088a2/60-Keyboard/README.md

# DIY 60% Keyboard





  



---

A custom 60% ortholinear mechanical keyboard, built from scratch with a 3D-printed case and handwired matrix.  
Powered by an **ESP32-S3 Zero** microcontroller and programmed in **C++** for key scanning, debouncing, and USB HID input.

---

## Table of Contents

- [DIY 60% Keyboard](#diy-60-keyboard)
  - [Table of Contents](#table-of-contents)
  - [Features](#features)
  - [Components](#components)
  - [Tools \& Software](#tools--software)
  - [Wiring (high level)](#wiring-high-level)
  - [Assembly](#assembly)
  - [Keyboard Layout](#keyboard-layout)
    - [Layers](#layers)
  - [Design \& Gallery](#design--gallery)
  - [3D Print Settings](#3d-print-settings)
    - [Case \& plate](#case--plate)
    - [Keycaps](#keycaps)
  - [Pin Mapping](#pin-mapping)
  - [Firmware](#firmware)
    - [Quick start (Arduino IDE)](#quick-start-arduino-ide)
    - [Firmware notes](#firmware-notes)
  - [Future Improvements](#future-improvements)
  - [License](#license)

---

## Features

- Ortholinear (grid-style) key layout  
- 3D-printed case and plate design  
- Handwired switch matrix with diodes  
- ESP32-S3 Zero for USB HID functionality  
- Firmware written in C++ (Arduino / PlatformIO compatible)

---

## Components

- ESP32-S3 Zero (microcontroller)  
- 63 × Blue mechanical switches
- 63 × 1N4148 diodes (one per switch)  
- Keycaps Cherry MX style
- Wires (24-26 AWG preferred for handwiring)  
- 3D-printed case & plate  
- Screws, brass threaded inserts, stabilizers

---

## Tools & Software

- **Design & CAD**: Fusion 360
- **Slicing & Printing**: Orca Slicer & FDM 3D Printer
- **Firmware Development**: Arduino IDE / PlatformIO  
- **Programming Language**: C++  
- **Microcontroller Platform**: ESP32-S3 Zero  

---

## Wiring (high level)

1. Decide your matrix rows × columns based on your ortholinear layout (common 60% ortholinear uses a grid sized to the key count).  
2. Handwire switches into a matrix: one side of each switch goes to a row wire, the other side goes through a diode to a column wire.  
3. **Diode orientation:** place the **1N4148** diode on each switch such that current flows from the switch toward the column/scan line. In practice, orient the diode with its **striped end (cathode)** pointing to the column/scan line (the MCU side). This prevents ghosting during matrix scanning.  
4. Route row and column wires to ESP32-S3 Zero GPIOs. Reserve a few extra GPIOs for indicators or encoders if needed. Use internal pull-ups or external resistors per your scanning routine.

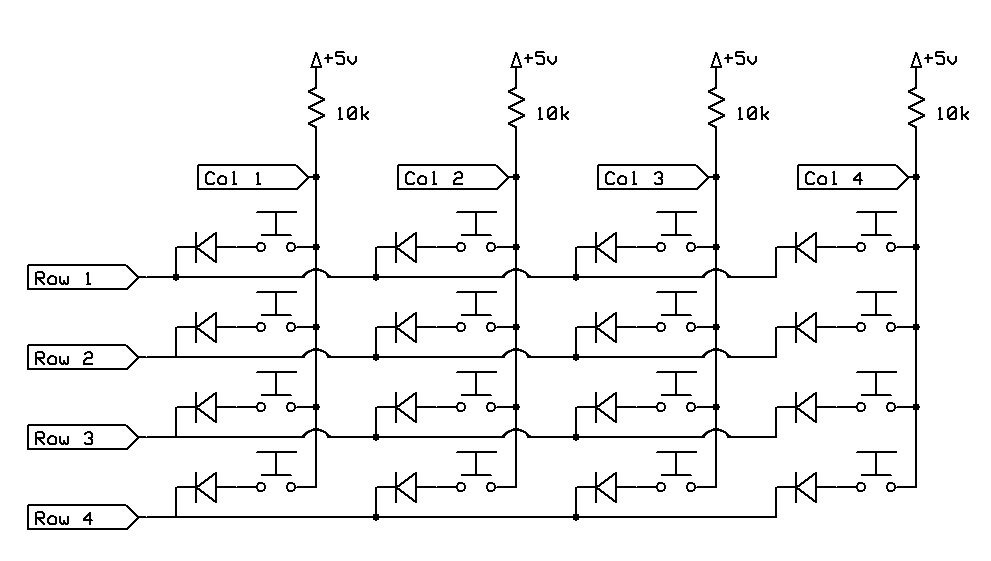
[picture p1: images/Keyboard_Matrix_Circuit.png]
Final Keyboard
  
*Keyboard Matrix Circuit — [Arduino Forum Reference](https://forum.arduino.cc/t/what-is-the-actual-circuitry-of-a-keypad-and-the-switch/1046828)*

---

## Assembly

- 3D-print the case and plate. Test fit switches and stabilizers before final assembly.  
- Solder diodes to switch pins first (striped end toward column).
- Solder row/column buses and label them (R0, R1, ... / C0, C1, ...).  
- Connect buses to the ESP32-S3 Zero following your planned pin mapping. Secure the MCU and wiring inside the case, then close and mount.

---

## Keyboard Layout

The keyboard follows a 60% ortholinear grid layout with layered functionality.  
This provides a compact footprint while still maintaining all essential keys.  

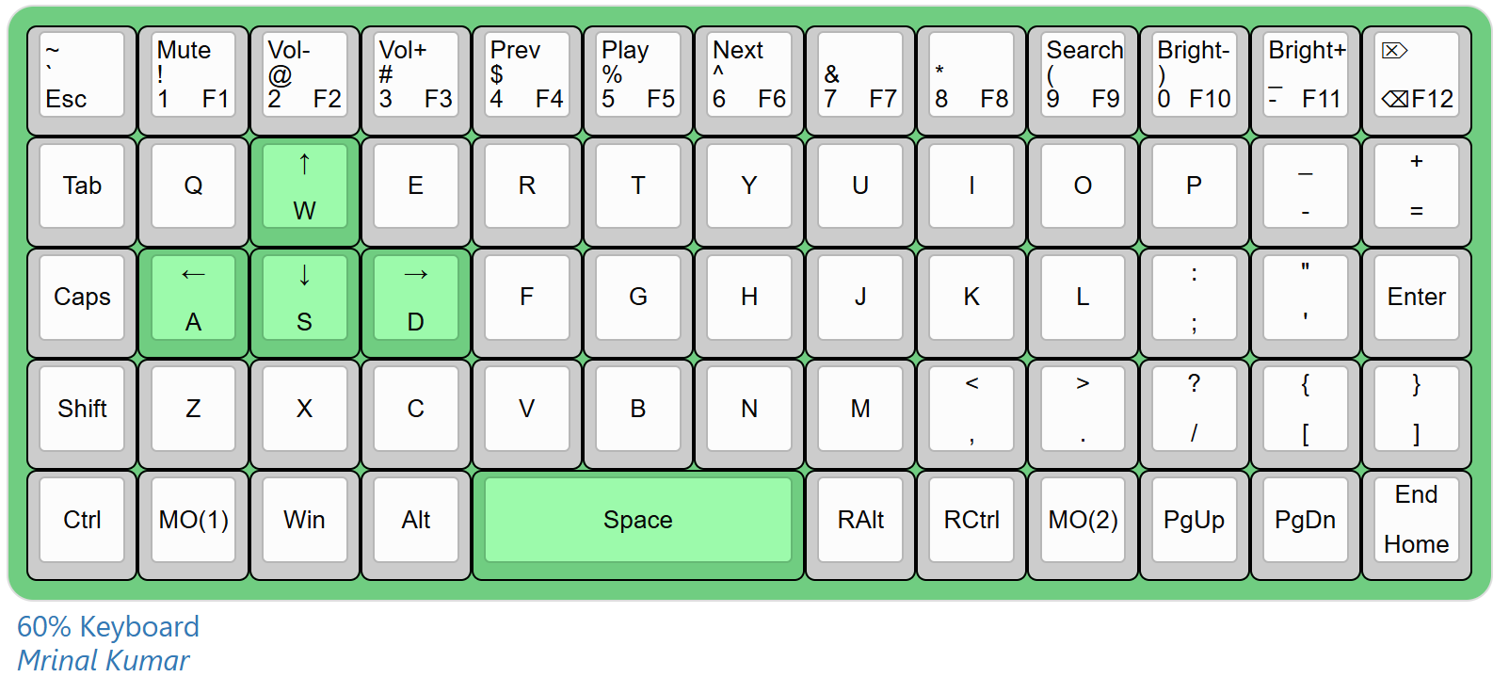
[picture p2: images/Keyboard_Layout.png]
Keyboard_Layout
  
*Keyboard layout (visualized using [Keyboard Layout Editor](https://www.keyboard-layout-editor.com/#/)).*

### Layers

- **Layer 1 (Default):** Standard typing layer with alphanumeric keys, modifiers, and space.  
- **Layer 2 (MO):** Media controls (volume, play/pause, next/previous).  
- **Layer 3 (MO):** Function keys (F1–F12) and system shortcuts.  

The editable layout file is included here: [`Keymap\60_keyboard.json`](./Keymap\60_keyboard.json)

---

## Design & Gallery

The complete CAD model of the keyboard is included in the repository:  

- [`3d_model/60_keyboard.step`](./3D_Model/60_Keyboard.step)

---

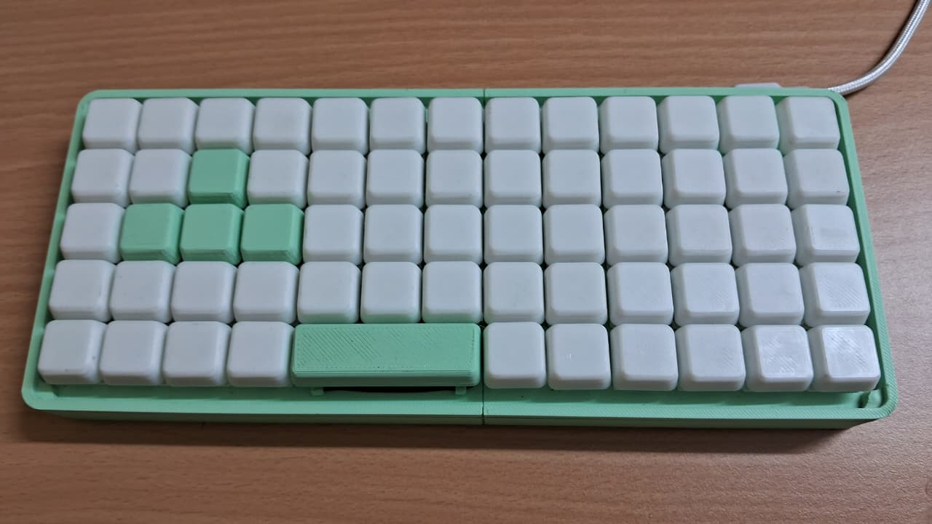
[picture p3: images/60_Keyboard.jpeg]
60_Keyboard 1

*60% keyboard*

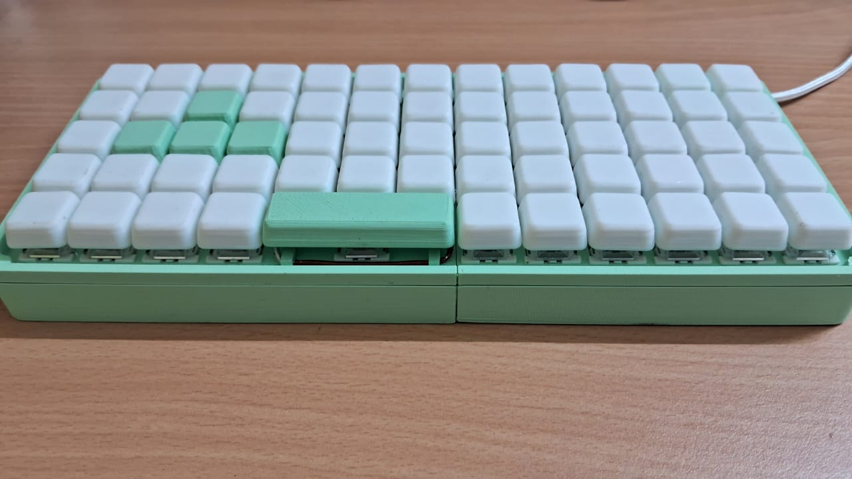
[picture p4: images/60_Keyboard_2.jpeg]
60_Keyboard 2
  
*60% keyboard*

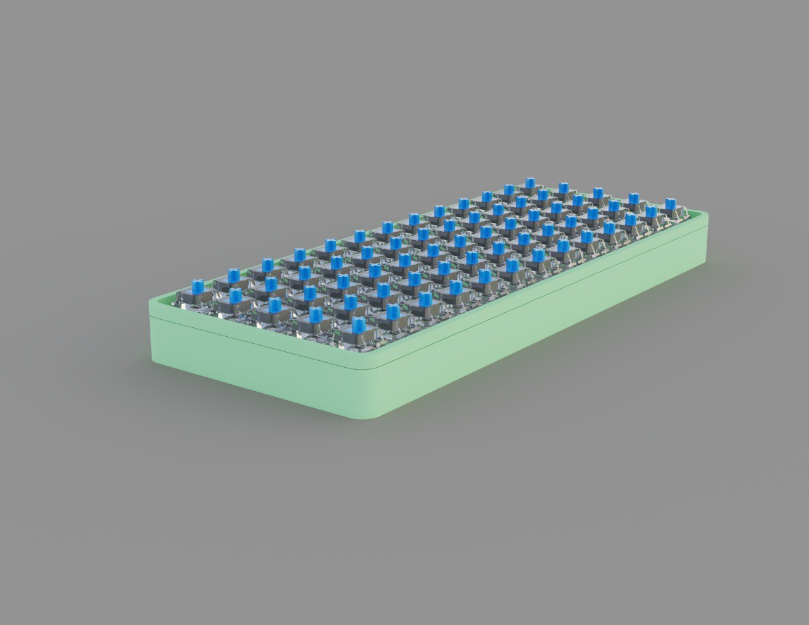
[picture p5: images/3D_Render_Old.jpeg]
3D Render Old
  
*Early render — initial concept.*

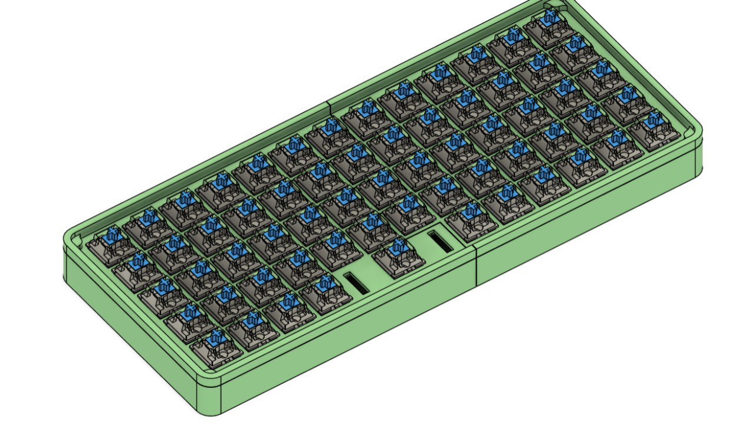
[picture p6: images/3D_Model_2.png]
3D Model 2
  
*3D model — top view.*

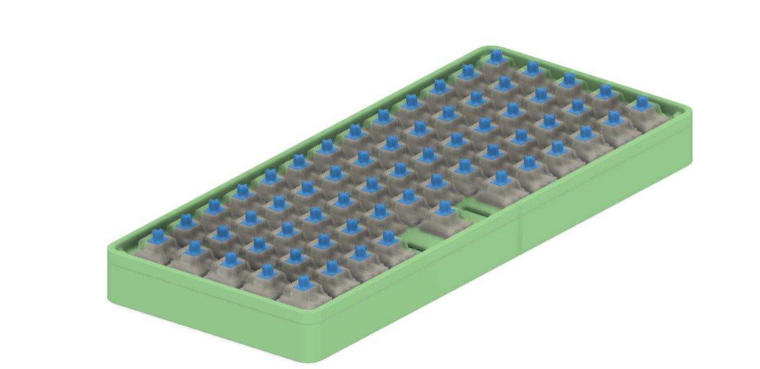
[picture p7: images/3D_Model_1.png]
3D Model 1
  
*3D model — case design.*

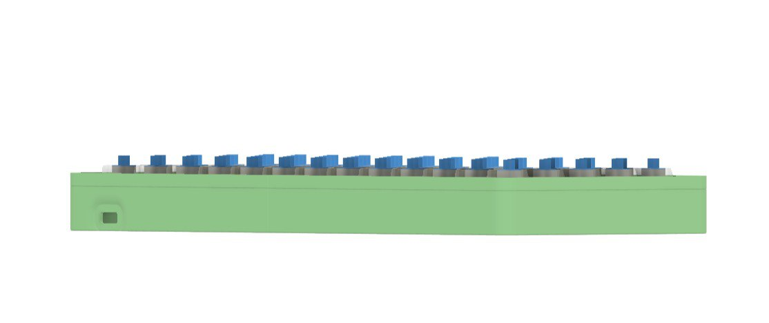
[picture p8: images/3D_Model_3.jpeg]
3D Model 3
  
*3D model — side view.*

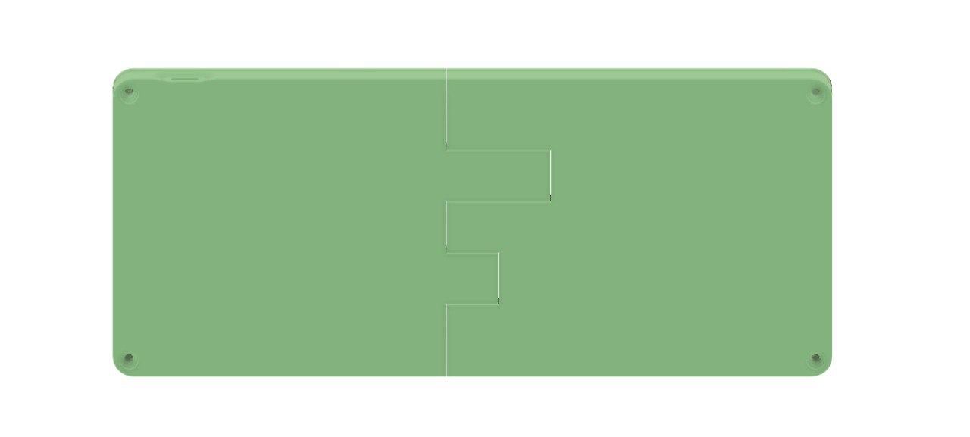
[picture p9: images/3D_Model_4.jpeg]
3D Model 4
  
*3D model — bottom view.*

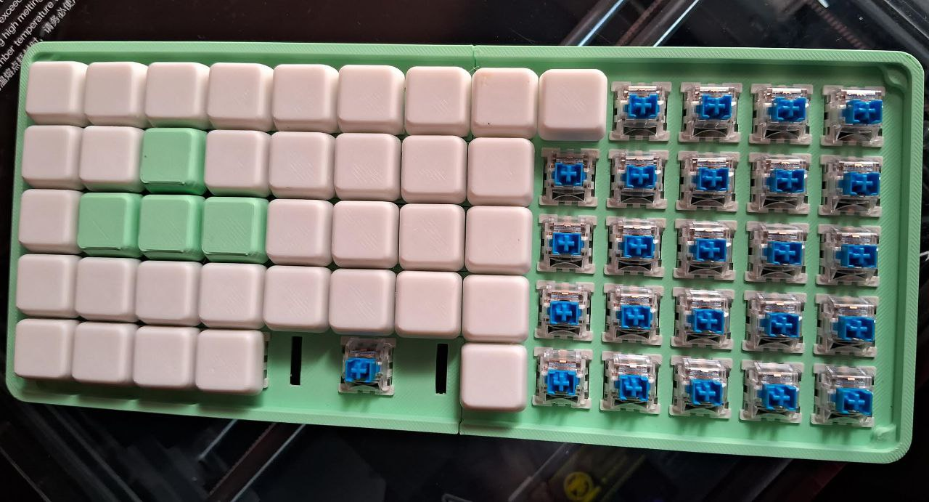
[picture p10: images/Added_Keys.png]
Added Keys
  
*Partial assembly*

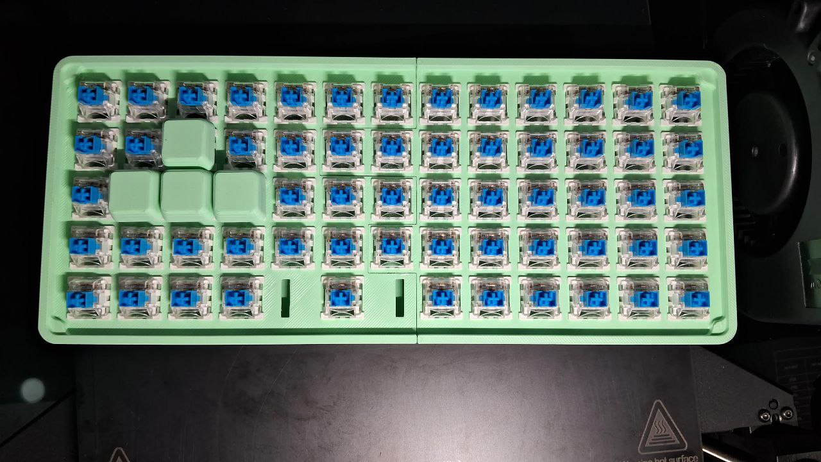
[picture p11: images/No_keycaps.png]
No keycaps
  
*Top view without keycaps — switch layout.*

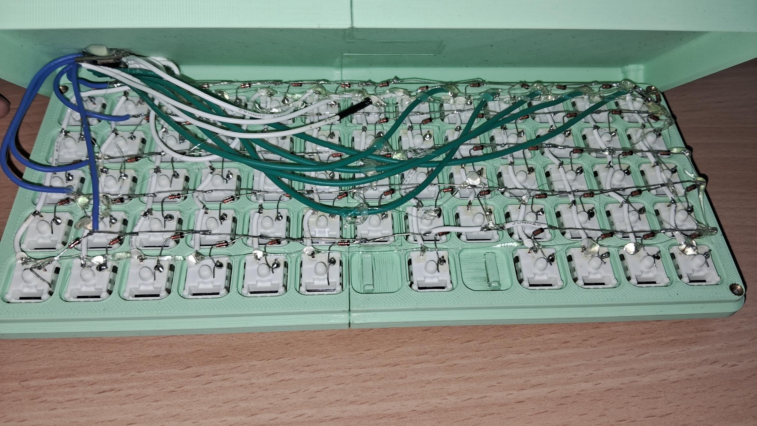
[picture p12: images/Circuit.jpg]
Handwired circuit
  
*Handwired matrix circuit*

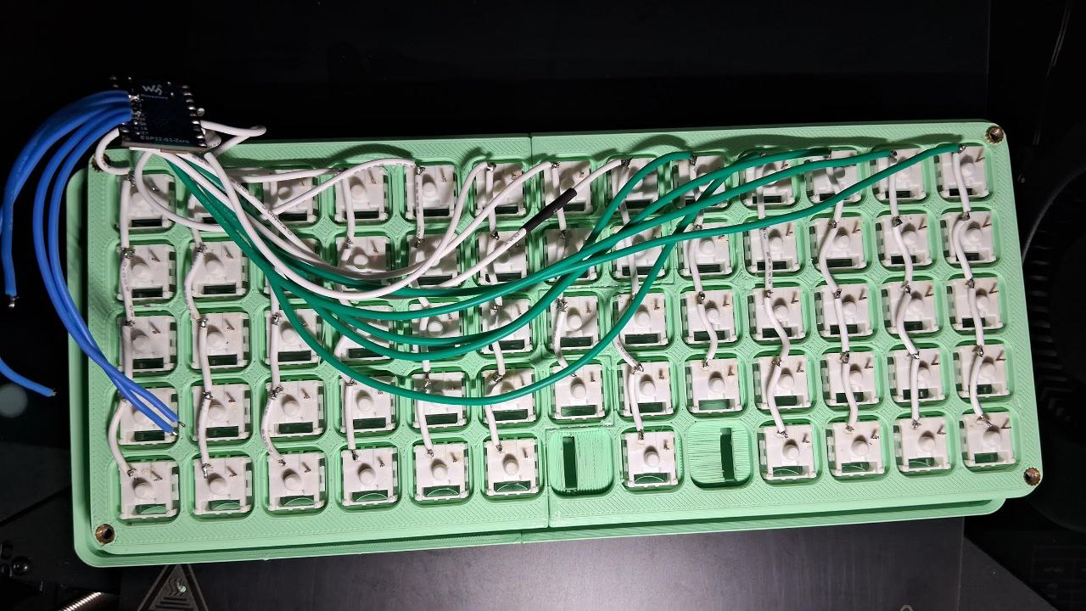
[picture p13: images/Handwired_circuit.png]
Handwired circuit
  
*Handwired matrix — bus routing. (Without Diodes)*

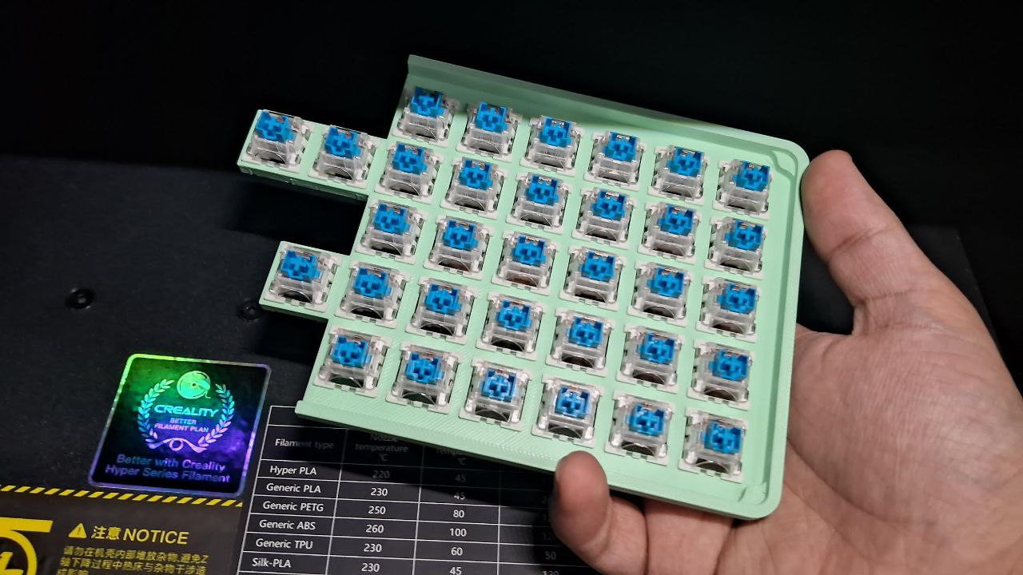
[picture p14: images/Top_Right_Frame_with_keys.png]
Top Right Frame with keys
  
*Top-right — keycap test fit.*

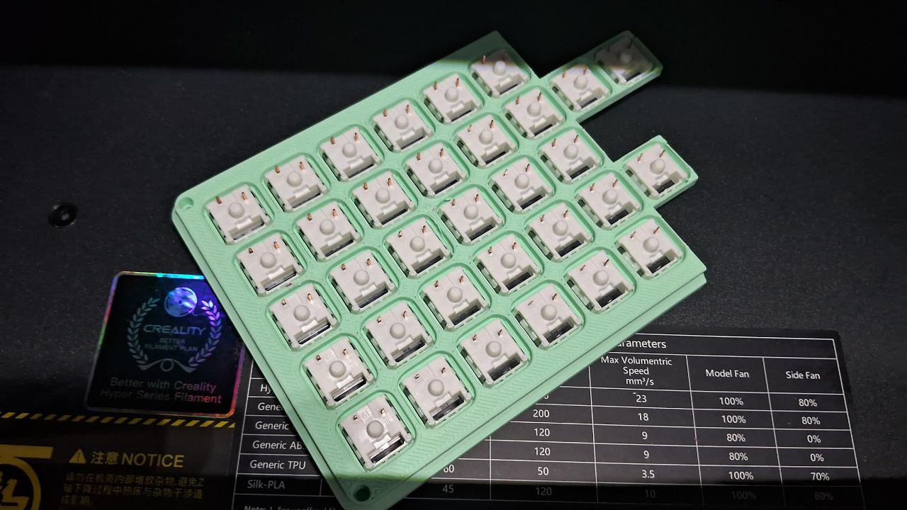
[picture p15: images/Frame_Backside.png]
Frame Backside
  
*Top-right — underside and keycaps points.*

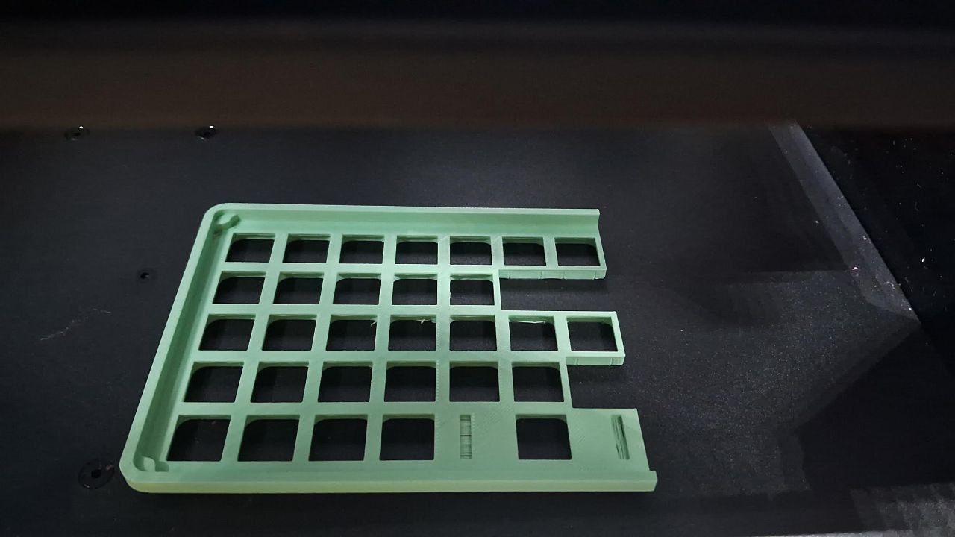
[picture p16: images/Top_left_frame.png]
Top left frame
  
*Top-left — Plate.*

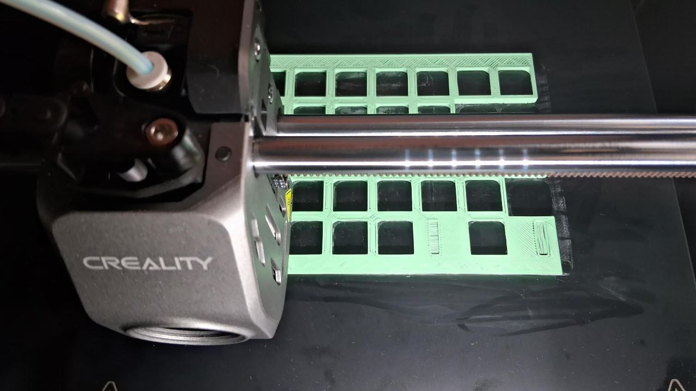
[picture p17: images/3D_Print.png]
3D_Print
  
*Top-Left — 3D Print.*

---

## 3D Print Settings

**Model:** The whole model is support free

**Printer:** any FDM printer with a 0.4 mm nozzle.

**Material:** PLA (recommended) - PETG or ABS for higher heat resistance

### Case & plate

- Layer height: **0.20 mm**
- Infill: **15%**
- Adhesion: none
- Supports: **none** (model designed support-free)  

### Keycaps

- Layer height: **0.16 mm** (for smoother finish)  
- Infill: **15%**
- Adhesion: none
- Supports: **none** (model designed support-free)  

---

## Pin Mapping

| Function | GPIOs |
|---|---|
| Rows (0 → 4) | 45, 42, 41, 17, 40 |
| Cols (0 → 12) | 13, 12, 11, 10, 9, 8, 7, 6, 5, 4, 3, 2, 1 |
| NeoPixel | 21 |

---

## Firmware

This project uses C++. You can use either the Arduino IDE (with ESP32 board installed) or PlatformIO.

### Quick start (Arduino IDE)

1. Install ESP32 board support (Espressif) in Arduino IDE.  
2. Open the provided `Firmware/` sketch.  
3. Edit the `ROW_PINS[]` and `COL_PINS[]` arrays to match your wiring.  
4. Select the ESP32-S3 Zero board and the correct port.  
5. Upload.

### Firmware notes

- Implement a debouncing routine (5–20 ms typical) to avoid chatter.  
- Use a matrix scanning algorithm that drives columns (or rows) actively and reads inputs on the other side.  
- Configure USB HID descriptors correctly for keyboard behavior.  
- Keep serial debugging optional (enable via a compile flag) so HID is unaffected.

---

## Future Improvements

While the current build is fully functional, there can be upgrades in future iterations:

- **Per-Key RGB lighting**: NeoPixel/WS2812B LEDs for customizable effects.  
- **Wireless support**: use the ESP32-S3’s built-in Bluetooth for Bluetooth HID, making the keyboard usable without USB.  
- **Custom PCB**: replace handwiring with a dedicated PCB for cleaner routing, easier assembly, and better reliability.  

---

## License

This project is licensed under the [MIT License](./license).  
Copyright (c) 2025 Mrinal Kumar

---
