088a2/60-Keyboard/images/Final_Keyboard.png

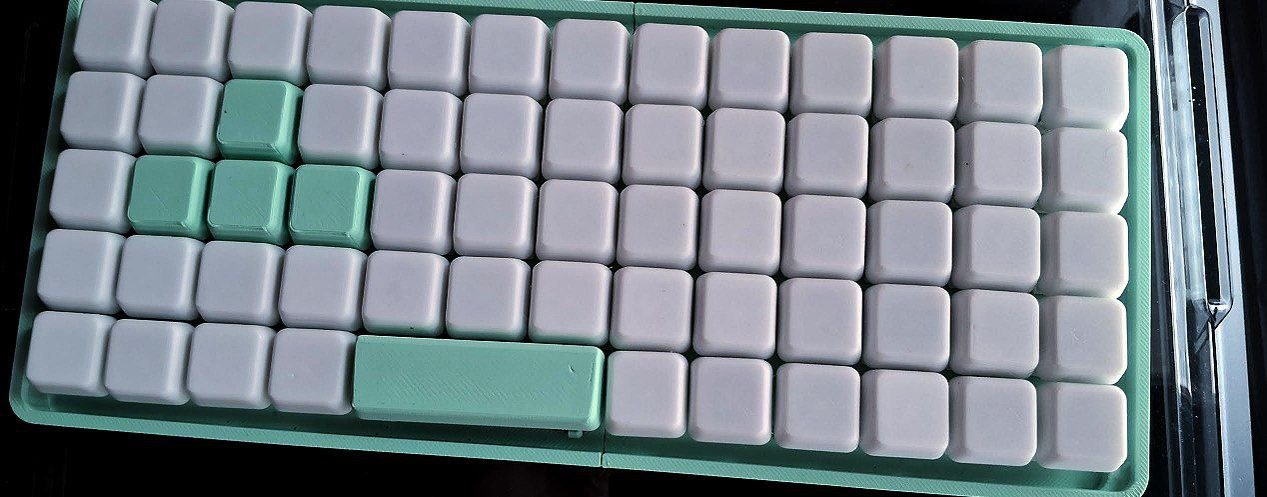
images/Final_Keyboard.png
