088a2/60-Keyboard/Firmware/Keyboard_60/keymap.h

#pragma once

#ifndef ROWS
  #define ROWS 5
#endif
#ifndef COLS
  #define COLS 13
#endif

const char* keyMap[ROWS][COLS] = {
  { "KC_ESC", "KC_1", "KC_2", "KC_3", "KC_4", "KC_5", "KC_6", "KC_7", "KC_8", "KC_9", "KC_0", "KC_BSLS", "KC_BSPC" },
  { "KC_TAB", "KC_Q", "KC_W", "KC_E", "KC_R", "KC_T", "KC_Y", "KC_U", "KC_I", "KC_O", "KC_P", "KC_MINS", "KC_EQL" },
  { "KC_CAPS", "KC_A", "KC_S", "KC_D", "KC_F", "KC_G", "KC_H", "KC_J", "KC_K", "KC_L", "KC_SCLN", "KC_QUOT", "KC_ENT" },
  { "KC_LSFT", "KC_Z", "KC_X", "KC_C", "KC_V", "KC_B", "KC_N", "KC_M", "KC_COMM", "KC_DOT", "KC_SLSH", "KC_LBRC", "KC_RBRC" },
  { "KC_LCTL", "MO(1)", "KC_LGUI", "KC_LALT", "KC_NO", "KC_SPC", "KC_NO", "KC_RALT", "KC_RCTL", "MO(2)", "KC_PGUP", "KC_PGDN", "KC_HOME" }
};
