088a2/60-Keyboard/Firmware/Keyboard_60/update_led.h

#pragma once

#include <Adafruit_NeoPixel.h>

extern Adafruit_NeoPixel pixels;
extern bool capsOn;
extern bool layer1Active;
extern bool layer2Active;

void updateCapsLED()
{

  if (capsOn) pixels.setPixelColor(0, pixels.Color(255, 255, 255, 0));       // white
  else if (!capsOn && !(layer1Active || layer2Active)) pixels.setPixelColor(0, pixels.Color(255, 0, 0, 0));  // green
  else if (!capsOn && layer1Active) pixels.setPixelColor(0, pixels.Color(0, 0, 255, 0));  // blue
  else if (!capsOn && layer2Active) pixels.setPixelColor(0, pixels.Color(0, 255, 0, 0));  // red
  pixels.show();
}
