088a2/60-Keyboard/(notices)

Notices in the files:
README.md:
License: MIT
